AnnabellaPaoli/PEGASUS--Future-engineers-WRO-2026/schemes/esquema.png

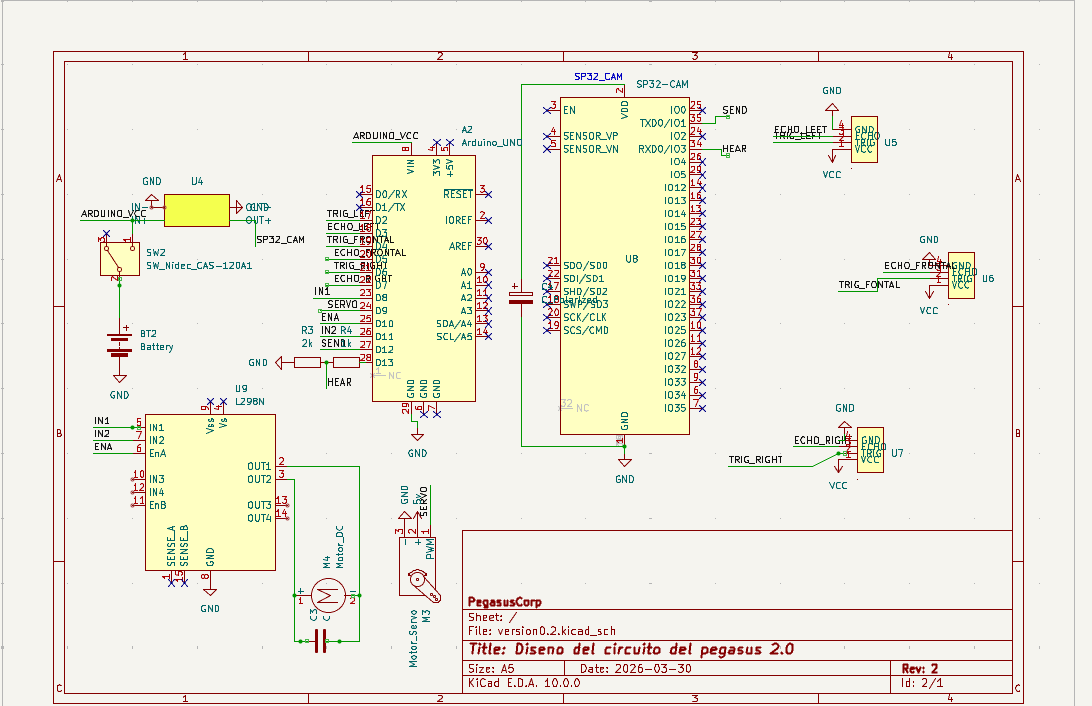
schemes/esquema.png
