AnnabellaPaoli/PEGASUS--Future-engineers-WRO-2026/t-photos/Working.jpeg

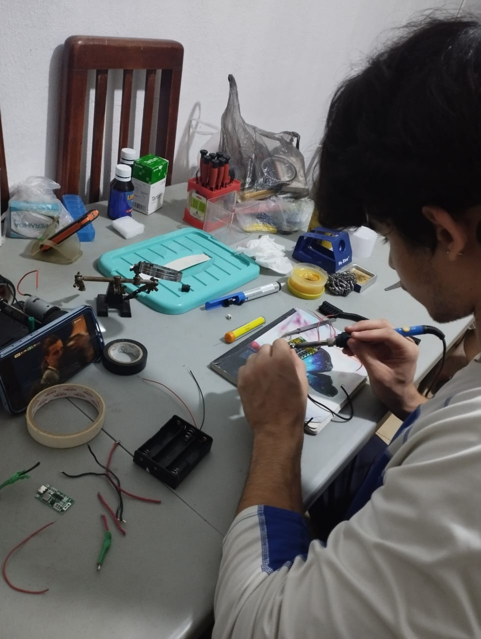
t-photos/Working.jpeg
