AnnabellaPaoli/PEGASUS--Future-engineers-WRO-2026/v-photos/front.jpeg

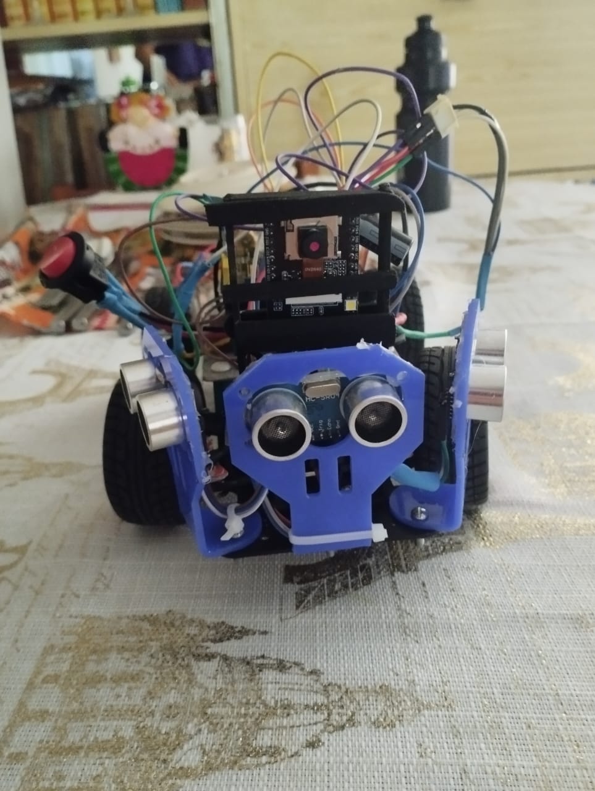
v-photos/front.jpeg
