AnnabellaPaoli/PEGASUS--Future-engineers-WRO-2026/v-photos/side.jpeg

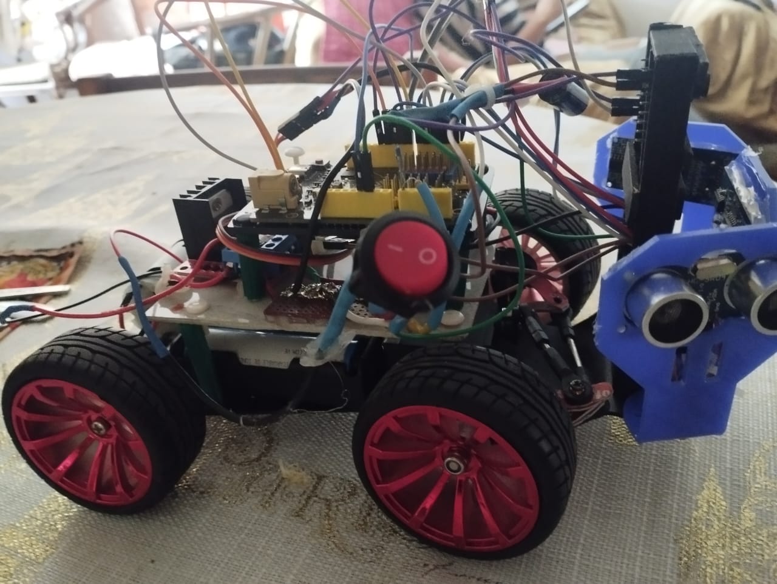
v-photos/side.jpeg
