AnnabellaPaoli/PEGASUS--Future-engineers-WRO-2026/v-photos/up.jpeg

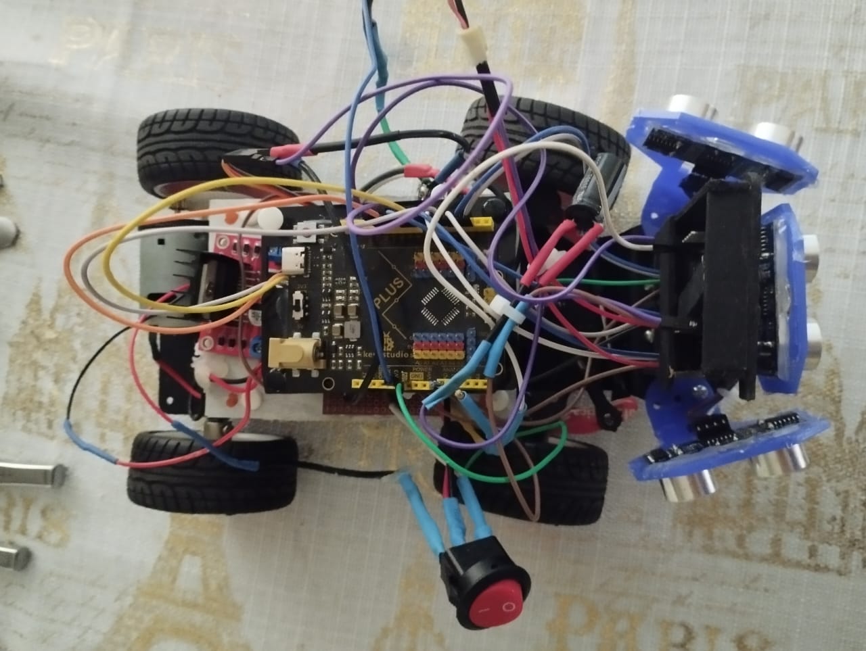
v-photos/up.jpeg
