AnnabellaPaoli/PEGASUS--Future-engineers-WRO-2026/v-photos/version one.jpeg

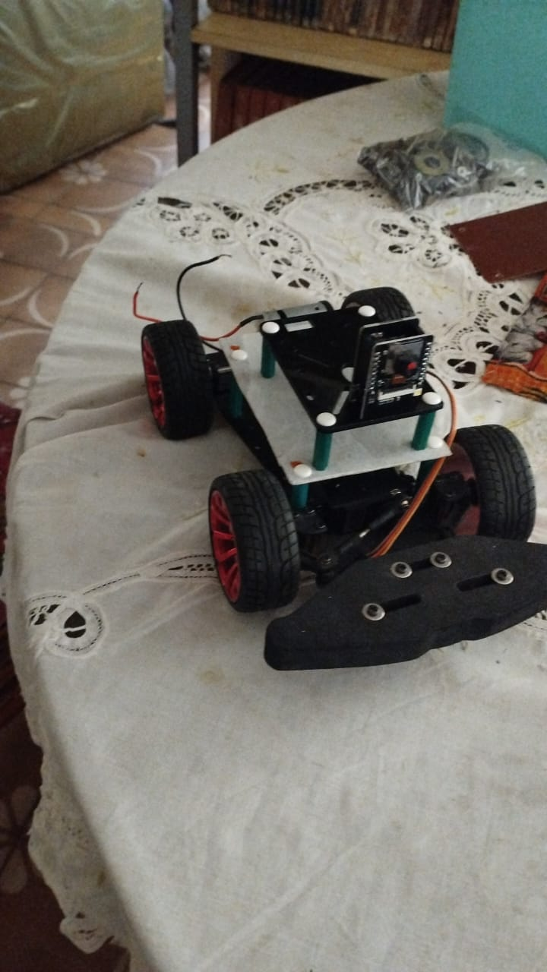
v-photos/version one.jpeg
