AnnabellaPaoli/PEGASUS--Future-engineers-WRO-2026/v-photos/version_zero.jpeg

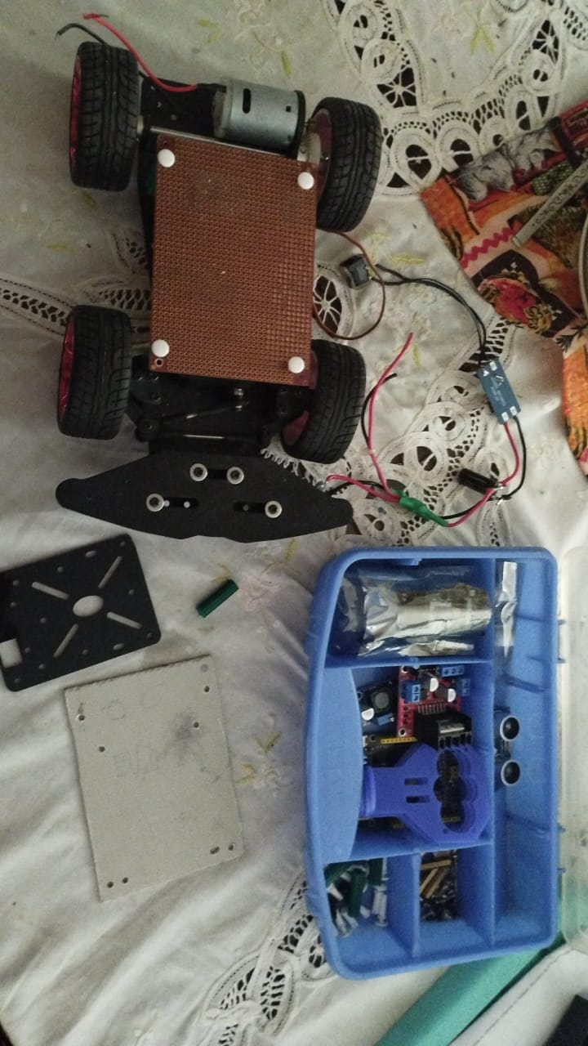
v-photos/version_zero.jpeg
