AnnabellaPaoli/PEGASUS--Future-engineers-WRO-2026/(commit log)

2026-03-04 Initial commit: Pegasus prototype
2026-03-20 First probe to use ultrasonic sensor
2026-08-21 Update Arduino's code and Sp32's code
2026-08-22 docs: solving diagram's error and reorganize project in libraries
    [CameraConfig.h, CameraLink.cpp, CameraLink.h, ColorVision.cpp, ColorVision.h, Config.h, Maneuvers.cpp, Maneuvers.h]
